socrates018/350a-hall-analog-power-meter/README.md

# 350a-hall-analog-power-meter
A custom power meter designed in EasyEDA, supporting currents up to 350A. It provides analog voltage and current outputs and includes a 5V synchronous buck converter for powering the Cube Orange+ flight controller. Developed for the [Starbound Team](https://starbound.e-ce.uth.gr/) for the 2026 [UAS challenge](https://www.imeche.org/events/challenges/uas-challenge). 
The PCB is split into two Gerber files (front and back) to avoid the cost of multiple designs in one PCB.

**2D Layout**
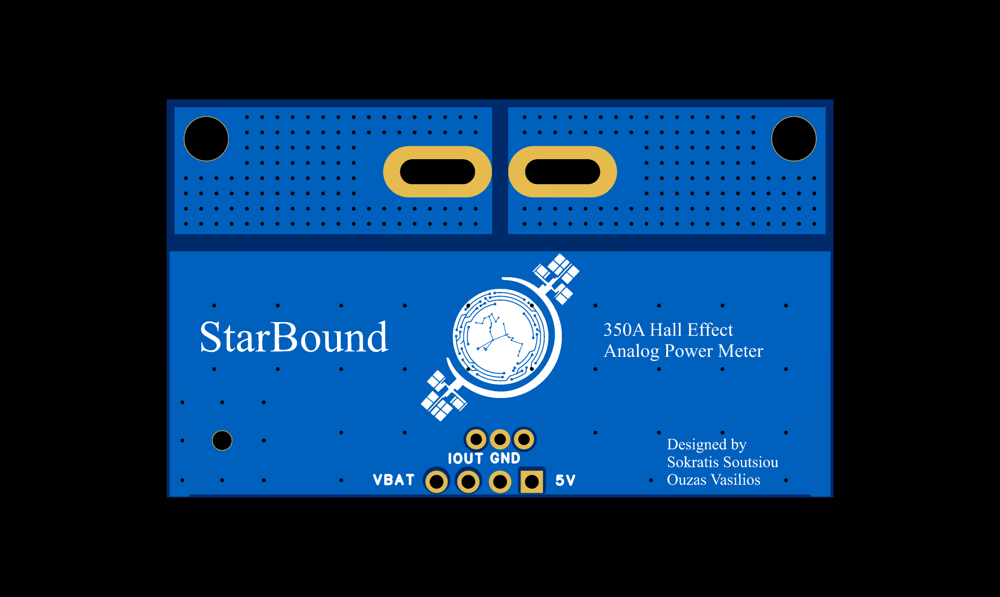
[picture p1: 2D_PCB1_BACK_LOGO.png]
Back PCB (Underside)

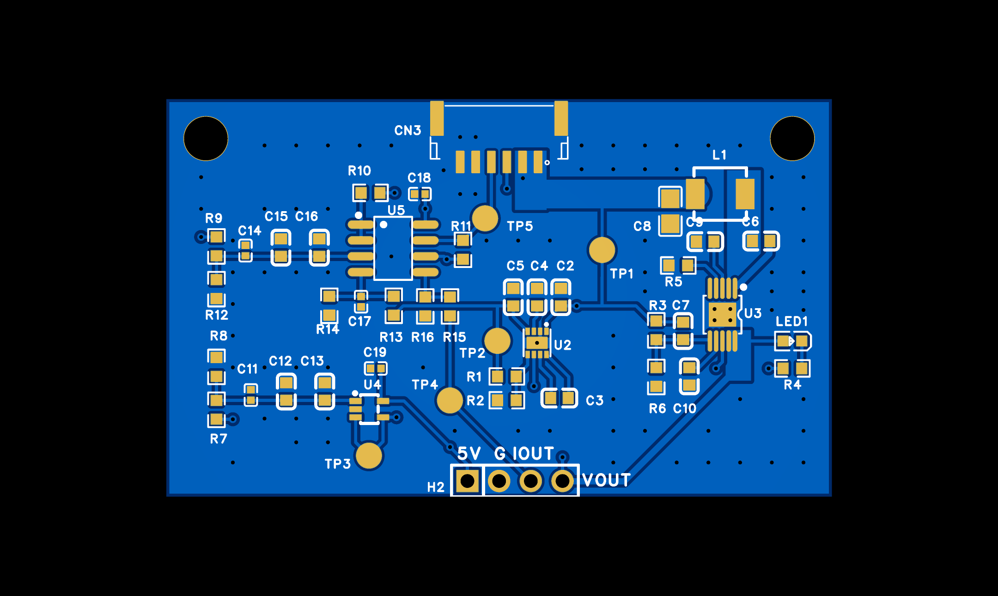
[picture p2: 2D_PCB1_FRONT.png]
Front PCB
  
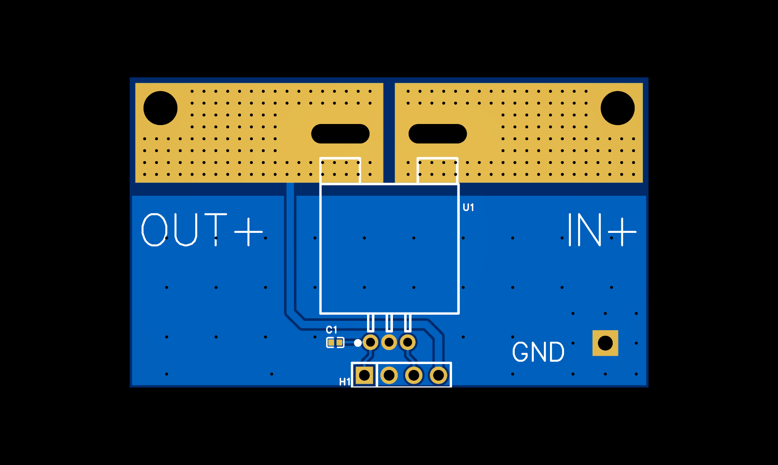
[picture p3: 2D_PCB1_BACK.png]
Back PCB


**3D View (with components)**
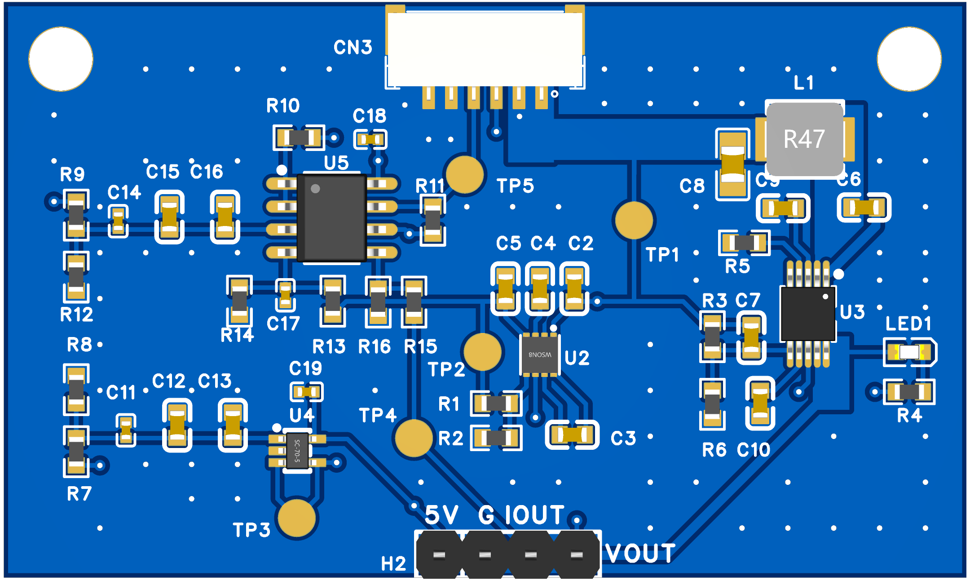
[picture p4: 3D_PCB1_FRONT.png]
Front PCB 3D
  
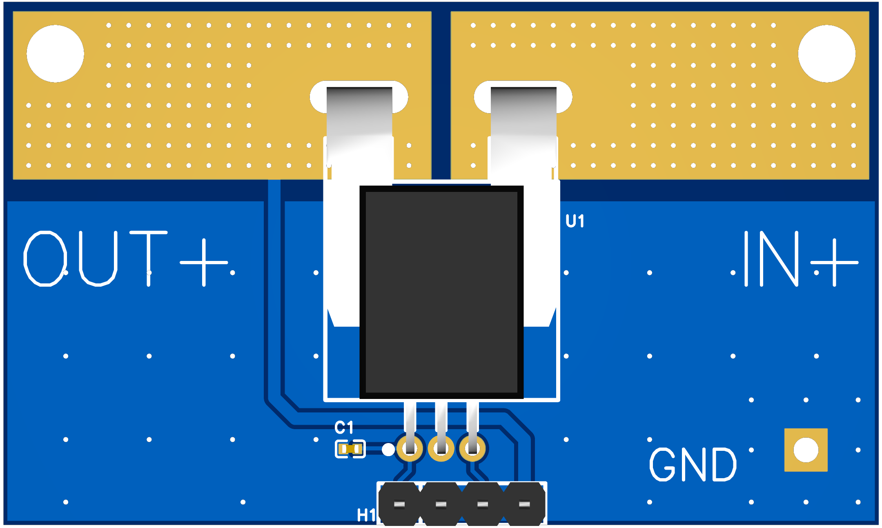
[picture p5: 3D_PCB1_BACK.png]
Back PCB 3D
