socrates018/350a-hall-analog-power-meter/BACK/BOM_Back_PCB1_2026-06-01.xlsx

No. | Quantity | Comment | Designator | Footprint | Value | Manufacturer Part | Manufacturer | Supplier Part | Supplier
1 | 1 | 100nF | C1 | C0402 | 100nF | CL05B104KO5NNNC | SAMSUNG(三星) | C1525 | LCSC
2 | 1 | PZ254V-11-04P | H1 | HDR-TH_4P-P2.54-V-M |  | PZ254V-11-04P | XFCN(兴飞) | C2691448 | LCSC
3 | 1 | ACS770ECB-400B-PFF-T | U1 | CB-5_L13.0-W10.0-P1.91-LS21.4-BR |  | ACS770ECB-400B-PFF-T | ALLEGRO(美国埃戈罗) | C32246945 | LCSC
