socrates018/350a-hall-analog-power-meter/FRONT/BOM_Front_PCB1_2026-06-01.xlsx

No. | Quantity | Comment | Designator | Footprint | Value | Manufacturer Part | Manufacturer | Supplier Part | Supplier
1 | 2 | 4.7uF | C2,C5 | C0603 | 4.7uF | CL10A475KO8NNNC | SAMSUNG(三星) | C19666 | LCSC
2 | 3 | 2.2uF | C3,C4,C9 | C0603 | 2.2uF | CL10A225KO8NNNC | SAMSUNG(三星) | C23630 | LCSC
3 | 1 | 100nF | C6 | C0603 | 100nF | CC0603KRX7R9BB104 | YAGEO(国巨) | C14663 | LCSC
4 | 1 | 10pF | C7 | C0603 | 10pF | CL10C100JB8NNNC | SAMSUNG(三星) | C1634 | LCSC
5 | 1 | 47uF | C8 | C0805 | 47uF | CL21A476MQYNNNE | SAMSUNG(三星) | C16780 | LCSC
6 | 3 | 10nF | C10,C12,C15 | C0603 | 10nF | 0603B103K500NT | FH(风华) | C57112 | LCSC
7 | 5 | 100nF | C11,C14,C17,C18,C19 | C0402 | 100nF | CL05B104KO5NNNC | SAMSUNG(三星) | C1525 | LCSC
8 | 2 | 1nF | C13,C16 | C0603 | 1nF | CL10B102KB8NNNC | SAMSUNG(三星) | C1588 | LCSC
9 | 1 | SM06B-GHS-TB(LF)(SN) | CN3 | CONN-TH_SM06B-GHS-TB-LF-SN |  | SM06B-GHS-TB(LF)(SN) | JST | C133065 | LCSC
10 | 1 | 2.2uH | L1 | IND-SMD_L4.4-W4.0_PHC0420 | 2.2uH | APH0420T2R2M | APV(爱普微) | C5349665 | LCSC
11 | 1 | KT-0603R | LED1 | LED0603-RD |  | KT-0603R | KENTO | C2286 | LCSC
12 | 1 | 330kΩ | R1 | R0603 | 330kΩ | FRC0603F3303TS | FOJAN(富捷) | C2907027 | LCSC
13 | 1 | 100kΩ | R2 | R0603 | 100kΩ | RC0603FR-07100KL | YAGEO(国巨) | C14675 | LCSC
14 | 1 | 1MΩ | R3 | R0603 | 1MΩ | 0603WAF1004T5E | UNI-ROYAL(厚声) | C22935 | LCSC
15 | 1 | 10kΩ | R4 | R0603 | 10kΩ | 0603WAF1002T5E | UNI-ROYAL(厚声) | C25804 | LCSC
16 | 1 | 16.2kΩ | R5 | R0603 | 16.2kΩ | RT0603BRD0716K2L | YAGEO(国巨) | C728583 | LCSC
17 | 1 | 180kΩ | R6 | R0603 | 180kΩ | 0603WAF1803T5E | UNI-ROYAL(厚声) | C22827 | LCSC
18 | 1 | 11kΩ | R7 | R0603 | 11kΩ | ERA3AEB113V | PANASONIC(松下) | C473242 | LCSC
19 | 3 | 1kΩ | R8,R9,R12 | R0603 | 1kΩ | RT0603BRD071KL | YAGEO(国巨) | C110776 | LCSC
20 | 2 | 2kΩ | R10,R15 | R0603 | 2kΩ | RT0603BRD072KL | YAGEO(国巨) | C728588 | LCSC
21 | 2 | 3.3kΩ | R11,R16 | R0603 | 3.3kΩ | RT0603BRD073K3L | YAGEO(国巨) | C309653 | LCSC
22 | 1 | use for -5V | R13 | R0603 | 0Ω | RC0603JR-070RL | YAGEO(国巨) | C95177 | LCSC
23 | 5 | Test-Point | TP1,TP2,TP3,TP4,TP5 | Test-Point-0.5mm
24 | 1 | LM27761DSGR | U2 | WSON-8_L2.0-W2.0-P0.65-BL-EP |  | LM27761DSGR | TI(德州仪器) | C129351 | LCSC
25 | 1 | LT8609EMSE#PBF | U3 | MSOP-10_L3.0-W3.0-P0.50-LS5.0-BL-EP |  | LT8609EMSE#PBF | ADI(亚德诺) | C580303 | LCSC
26 | 1 | OPA391DCKR | U4 | SC-70-5_L2.1-W1.3-P0.65-LS2.1-BR |  | OPA391DCKR | TI(德州仪器) | C2871876 | LCSC
27 | 1 | OPA2192IDR | U5 | SOIC-8_L4.9-W3.9-P1.27-LS6.0-BL |  | OPA2192IDR | TI(德州仪器) | C110074 | LCSC
