socrates018/350a-hall-analog-power-meter/SCH_Schematic1_2026-05-11.pdf

# XT90PW-M.G.Y 300A Hall Power MeterSchematic1.Current Meter

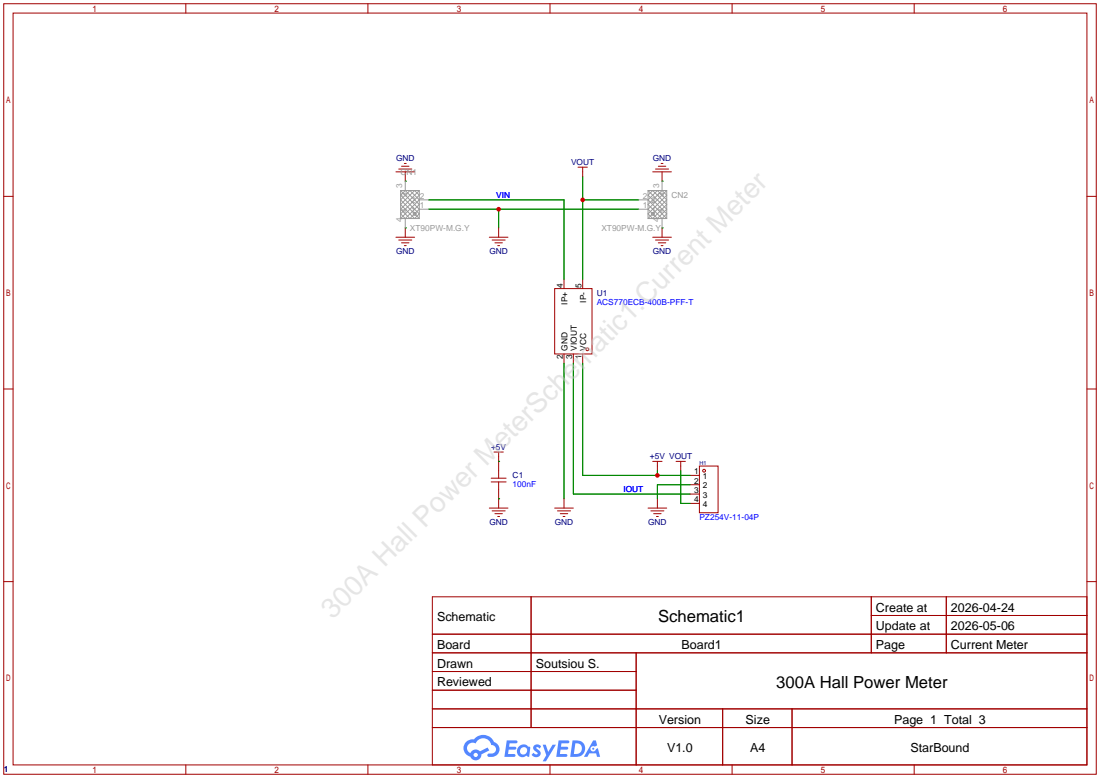
[picture p6: page 1]

Schematic | Schematic1 | Create at | 2026-04-24

Update at | 2026-05-06

Board | Board1 | Page | Current Meter
Drawn | Soutsiou S. | 300A Hall Power Meter
Reviewed

Version | Size | Page 1 Total 3
V1.0 | A4 | StarBound

# 47uF 300A Hall Power MeterSchematic1.Buck Converter

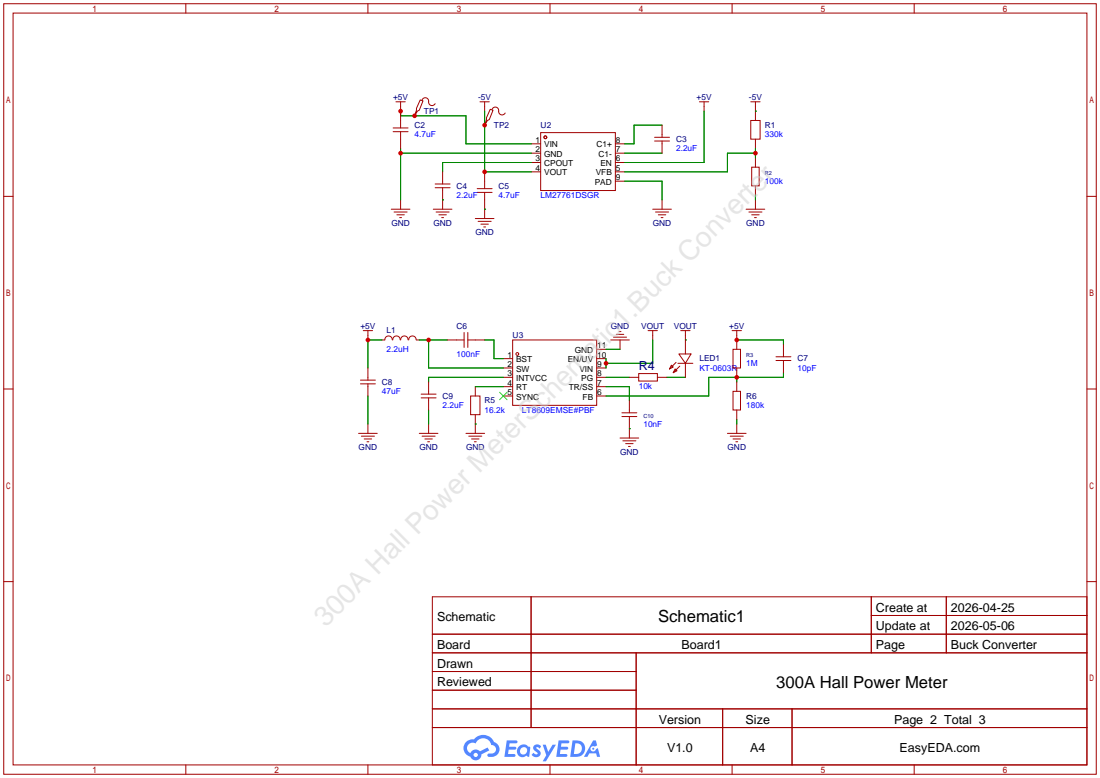
[picture p7: page 2]

Schematic | Schematic1 | Create at | 2026-04-25

Update at | 2026-05-06

Board | Board1 | Page | Buck Converter
Drawn | | 300A Hall Power Meter
Reviewed

Version | Size | Page 2 Total 3
V1.0 | A4 | EasyEDA.com

# PZ254V-11-04P 300A Hall Power MeterSchematic1.Signal Processing

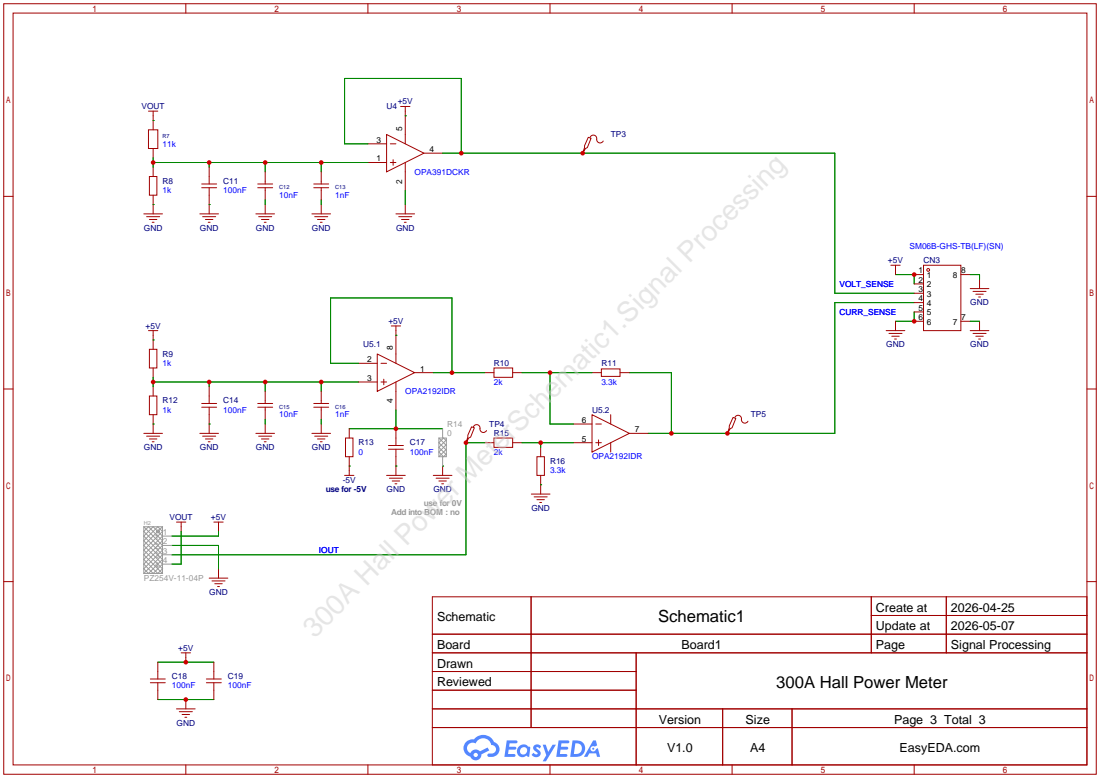
[picture p8: page 3]

use for 0V
Add into BOM : no

Schematic | Schematic1 | Create at | 2026-04-25

Update at | 2026-05-07

Board | Board1 | Page | Signal Processing
Drawn | | 300A Hall Power Meter
Reviewed

Version | Size | Page 3 Total 3
V1.0 | A4 | EasyEDA.com
