socrates018/350a-hall-analog-power-meter/(list of files, drawings)

Other design files:
300A Hall Power Meter.eprj
