socrates018/350a-hall-analog-power-meter/(commit log)

2026-05-03 Add EasyEDA project and image files
    [300A Hall Power Meter.eprj]
2026-05-07 Add more vias and use mostly basic easyeda components
    [300A Hall Power Meter.eprj]
2026-05-08 Added Gerbers
2026-05-10 Add Schematic
2026-05-10 Add combined BOM
    [BOM_Board1_Schematic1_2026-05-11.xlsx]
2026-05-10 Add Back PCB underside render
2026-06-01 Add correct files for both sides
    [300A Hall Power Meter.eprj, BOM_Back_PCB1_2026-06-01.xlsx, BOM_Board1_Schematic1_2026-05-11.xlsx, BOM_Front_PCB1_2026-06-01.xlsx, PickAndPlace_Back_2026-06-01.xlsx, PickAndPlace_Front_2026-06-01.xlsx]
